icchalmers/Sit-To-Stand/BLEVibrator/Hardware/PCB/StrokeRehabilitation_KiCost.xlsx

 |  |  |  |  |  |  | Board Qty: | 100
 |  |  |  |  |  |  | Total Cost: | $0.00 |  |  |  | $0.00 |  |  |  |  |  | $0.00 |  |  |  |  |  | $0.00 |  |  |  |  |  | $0.00 |  |  |  |  |  | $0.00
 |  |  |  |  |  |  | Unit Cost: | $0.00
Global Part Info |  |  |  |  |  |  |  |  | Digi-Key |  |  |  |  |  | Mouser |  |  |  |  |  | Newark |  |  |  |  |  | Kitronik |  |  |  |  |  | Precisionmicrodrives
Refs | Value | Desc | Footprint | Manf | Manf# | Qty | Unit$ | Ext$ | Avail | Purch | Unit$ | Ext$ | Cat# | Doc | Avail | Purch | Unit$ | Ext$ | Cat# | Doc | Avail | Purch | Unit$ | Ext$ | Cat# | Doc | Avail | Purch | Unit$ | Ext$ | Cat# | Doc | Avail | Purch | Unit$ | Ext$ | Cat# | Doc
U1 | MCP73833 |  | IainPersonalLibrary:MCP73833-XXX_MF |  | MCP73833T-FCI/MF | 0 | $0.00 | $0.00 | 0 |  | $0.00 | $0.00 | MCP73833T-FCI/MF-ND | Link (http://www.digikey.com/scripts/DkSearch/dksus.dll?WT.z_header=search_go&lang=en) | 13336 |  | $0.00 | $0.00 | 579-MCP73833T-FCI/MF | Link (http://www.mouser.co.uk/Search/../ProductDetail/Microchip-Technology/MCP73833T-FCI-MF/) |  |  |  |  |  | Link (http://www.newark.com/webapp/wcs/stores/servlet/Search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)
U3 | RFD22301 |  | IainPersonalLibrary:RFD22301_RFDuino |  | RFD22301 | 0 | $0.00 | $0.00 | 3691 |  | $0.00 | $0.00 | 1562-1016-ND | Link (http://www.digikey.com/scripts/DkSearch/dksus.dll?WT.z_header=search_go&lang=en&keywords=RFD22301%20) | 2141 |  | $0.00 | $0.00 | 975-RFD22301 | Link (http://www.mouser.co.uk/Search/../ProductDetail/RF-Digital-Wireless/RFD22301/)
R3 | 5k |  | IainPersonalLibrary:Yageo_resistor_SMD_0805_reflow |  | RC0805FR-074K99L | 0 | $0.00 | $0.00 | 453863 |  | $0.00 | $0.00 | 311-4.99KCRCT-ND | Link (http://www.digikey.com/product-detail/en/yageo/RC0805FR-074K99L/311-4.99KCRCT-ND/730885) | 36675 |  | $0.00 | $0.00 | 603-RC0805FR-074K99L | Link (http://www.mouser.co.uk/Search/Refine.aspx?Keyword=RC0805FR-074K99L%20) |  |  |  |  |  | Link (http://www.newark.com/webapp/wcs/stores/servlet/Search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)
R1,R2,R6,R7 | 330 |  | IainPersonalLibrary:Yageo_resistor_SMD_0805_reflow |  | RC0805FR-07330RL | 0 | $0.00 | $0.00 | 549110 |  | $0.00 | $0.00 | 311-330CRCT-ND | Link (http://www.digikey.com/product-detail/en/yageo/RC0805FR-07330RL/311-330CRCT-ND/730813) | 73460 |  | $0.00 | $0.00 | 603-RC0805FR-07330RL | Link (http://www.mouser.co.uk/Search/Refine.aspx?Keyword=RC0805FR-07330RL%20) |  |  |  |  |  | Link (http://www.newark.com/yageo-phycomp/rc0805fr-07330rl/surface-mount-chip-resistor-thick/dp/48Y4545)
C5 | 100n |  | Capacitors_SMD:C_0603 |  | C1608X7R1E104K080AA | 0 | $0.00 | $0.00 | 1276107 |  | $0.00 | $0.00 | 445-1316-1-ND | Link (http://www.digikey.com/product-detail/en/tdk-corporation/C1608X7R1E104K080AA/445-1316-1-ND/567697) | 745369 |  | $0.00 | $0.00 | 810-C1608X7R1E104K | Link (http://www.mouser.co.uk/Search/Refine.aspx?Keyword=C1608X7R1E104K080AA%20) | 4250 |  | $0.00 | $0.00 | 90R7696 | Link (http://www.newark.com/tdk/c1608x7r1e104k080aa/ceramic-capacitor-0-1uf-25v-x7r/dp/90R7696)
C1,C2 | 1uF |  | IainPersonalLibrary:Murata_capacitor_SMD_0805_reflow |  | GRM21BR71C105KA01L | 0 | $0.00 | $0.00 | 209929 |  | $0.00 | $0.00 | 490-1691-1-ND | Link (http://www.digikey.com/product-detail/en/murata-electronics-north-america/GRM21BR71C105KA01L/490-1691-1-ND/587411) | 100112 |  | $0.00 | $0.00 | 81-GRM40X105K16L | Link (http://www.mouser.co.uk/Search/Refine.aspx?Keyword=GRM21BR71C105KA01L%20) | 6361 |  | $0.00 | $0.00 | 97K0638 | Link (http://www.newark.com/murata/grm21br71c105ka01l/capacitor-ceramic-1uf-16v-x7r/dp/97K0638)
D1,D3 | BI_LED_common_anode |  | IainPersonalLibrary:Bi_LED_SM1204BC-RG |  | SM1204BC-R/G | 0 | $0.00 | $0.00 | 0 |  | $0.00 | $0.00 | SM1204BC-R/G-ND | Link (http://www.digikey.com/scripts/DkSearch/dksus.dll?WT.z_header=search_go&lang=en) | 1853 |  | $0.00 | $0.00 | 749-SM1204BC-R/G | Link (http://www.mouser.co.uk/Search/Refine.aspx?Keyword=SM1204BC-R%2FG%20) |  |  |  |  |  | Link (http://www.newark.com/webapp/wcs/stores/servlet/Search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)
SW1 | SWITCH_INV |  | IainPersonalLibrary:SlideSwitch_SSSS810701 |  | SSSS810701 | 0 | $0.00 | $0.00 |  |  |  |  |  |  | 58585 |  | $0.00 | $0.00 | 688-SSSS810701 | Link (http://www.mouser.co.uk/Search/Refine.aspx?Keyword=SSSS810701%20)
Q2 | MOSFET_N |  | IainPersonalLibrary:MCPH3_SOT-323 |  | MCH3479-TL-H | 0 | $0.00 | $0.00 | 0 |  | $0.00 | $0.00 | MCH3479-TL-H-ND | Link (http://www.digikey.com/scripts/DkSearch/dksus.dll?WT.z_header=search_go&lang=en) |  |  |  |  |  | Link (http://www.mouser.co.uk/Search/Refine.aspx?Keyword=MCH3479-TL-H%20)
CON1 | USB-MICRO-B |  | IainPersonalLibrary:Micro_USB_Amphenol_10118192-0001LF |  | 10118192-0001LF | 0 | $0.00 | $0.00 | 222099 |  | $0.00 | $0.00 | 609-4613-1-ND | Link (http://www.digikey.com/product-detail/en/amphenol-fci/10118192-0001LF/609-4613-1-ND/2785378) | 36570 |  | $0.00 | $0.00 | 649-10118192-0001LF | Link (http://www.mouser.co.uk/Search/Refine.aspx?Keyword=10118192-0001LF%20) | 2447 |  | $0.00 | $0.00 | 67T2258 | Link (http://www.newark.com/webapp/wcs/stores/servlet/Search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)
C3 | 10uF |  | IainPersonalLibrary:Murata_capacitor_SMD_0805_reflow |  | GRM21BR61C106KE15L | 0 | $0.00 | $0.00 | 693435 |  | $0.00 | $0.00 | 490-3886-1-ND | Link (http://www.digikey.com/product-detail/en/murata-electronics-north-america/GRM21BR61C106KE15L/490-3886-1-ND/965928) | 254793 |  | $0.00 | $0.00 | 81-GRM21BR61C106KE15 | Link (http://www.mouser.co.uk/Search/Refine.aspx?Keyword=GRM21BR61C106KE15L%20) | 5307 |  | $0.00 | $0.00 | 35R0687 | Link (http://www.newark.com/murata/grm21br61c106ke15l/ceramic-capacitor-10uf-16v-x5r/dp/35R0687)
P2 | Programming Header |  | IainPersonalLibrary:RFDuino_programming_header |  |  | 0 | $0.00 | $0.00
P1 | CONN_01X01 |  | IainPersonalLibrary:TestPoint_SMD_1x1 |  |  | 0 | $0.00 | $0.00
R5,R8 | 50k |  | IainPersonalLibrary:Yageo_resistor_SMD_0805_reflow |  | RC0805FR-0749K9L | 0 | $0.00 | $0.00 | 153313 |  | $0.00 | $0.00 | 311-49.9KCRCT-ND | Link (http://www.digikey.com/product-detail/en/yageo/RC0805FR-0749K9L/311-49.9KCRCT-ND/730932) | 39576 |  | $0.00 | $0.00 | 603-RC0805FR-0749K9L | Link (http://www.mouser.co.uk/Search/Refine.aspx?Keyword=RC0805FR-0749K9L%20) |  |  |  |  |  | Link (http://www.newark.com/webapp/wcs/stores/servlet/Search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)
U2 | TPS73701_DRV_6 |  | IainPersonalLibrary:TPS73701_DRV_6 |  | TPS73733DRVR | 0 | $0.00 | $0.00 | 2923 |  | $0.00 | $0.00 | 296-40960-1-ND | Link (http://www.digikey.com/product-detail/en/texas-instruments/TPS73733DRVR/296-40960-1-ND/5178837) | 2280 |  | $0.00 | $0.00 | 595-TPS73733DRVR | Link (http://www.mouser.co.uk/Search/../ProductDetail/Texas-Instruments/TPS73733DRVR/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) |  |  |  |  |  | Link (http://www.newark.com/webapp/wcs/stores/servlet/Search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)
R4 | 10k |  | IainPersonalLibrary:Yageo_resistor_SMD_0805_reflow |  | RC0805FR-0710KL | 0 | $0.00 | $0.00 | 4019774 |  | $0.00 | $0.00 | 311-10.0KCRCT-ND | Link (http://www.digikey.com/product-detail/en/yageo/RC0805FR-0710KL/311-10.0KCRCT-ND/730482) | 721803 |  | $0.00 | $0.00 | 603-RC0805FR-0710KL | Link (http://www.mouser.co.uk/Search/Refine.aspx?Keyword=RC0805FR-0710KL%20) | 211447 |  | $0.00 | $0.00 | 68R0229 | Link (http://www.newark.com/webapp/wcs/stores/servlet/Search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)
R9 | 10M |  | Resistors_SMD:R_0603 |  | CRCW060310M0FKEA | 0 | $0.00 | $0.00 | 46211 |  | $0.00 | $0.00 | 541-10.0MHCT-ND | Link (http://www.digikey.com/product-detail/en/vishay-dale/CRCW060310M0FKEA/541-10.0MHCT-ND/1180266) | 64704 |  | $0.00 | $0.00 | 71-CRCW0603-10M-E3 | Link (http://www.mouser.co.uk/Search/../ProductDetail/Vishay-Dale/CRCW060310M0FKEA/) | 16618 |  | $0.00 | $0.00 | 52K8071 | Link (http://www.newark.com/vishay/crcw060310m0fkea/res-thick-film-10m-1-0-1w-0603/dp/52K8071)
C4 | 100p |  | IainPersonalLibrary:Murata_capacitor_SMD_0805_reflow |  | C0805C101J5GACTU | 0 | $0.00 | $0.00 | 311109 |  | $0.00 | $0.00 | 399-1122-1-ND | Link (http://www.digikey.com/product-detail/en/kemet/C0805C101J5GACTU/399-1122-1-ND/411397) | 251676 |  | $0.00 | $0.00 | 80-C0805C101J5G | Link (http://www.mouser.co.uk/Search/../ProductDetail/Kemet/C0805C101J5GACTU/) | 5774 |  | $0.00 | $0.00 | 70K9275 | Link (http://www.newark.com/kemet/c0805c101j5gactu/ceramic-capacitor-100pf-50v-c0g/dp/70K9275)
BT1 | 1S LiPo |  | IainPersonalLibrary:BatteryCon_WireSolder_0.8mm |  |  | 0 | $0.00 | $0.00 |  |  |  |  |  |  |  |  |  |  |  |  |  |  |  |  |  |  |  |  |  |  |  | Link (https://www.kitronik.co.uk/2209-polymer-lithium-ion-battery-37v-400mah.html)
Q1 | MOS_P |  | IainPersonalLibrary:Vishay_SOT-23 |  | SI2367DS-T1-GE3 | 0 | $0.00 | $0.00 | 8462 |  | $0.00 | $0.00 | SI2367DS-T1-GE3CT-ND | Link (http://www.digikey.com/product-detail/en/vishay-siliconix/SI2367DS-T1-GE3/SI2367DS-T1-GE3CT-ND/3758767) | 4784 |  | $0.00 | $0.00 | 781-SI2367DS-GE3 | Link (http://www.mouser.co.uk/Search/Refine.aspx?Keyword=SI2367DS-T1-GE3%20) | 627 |  | $0.00 | $0.00 | 35R6206 | Link (http://www.newark.com/vishay/si2367ds-t1-ge3/p-channel-mosfet-20v-3-8a/dp/35R6206)
D2,D4 | D_Schottky |  | IainPersonalLibrary:SOD-123F |  | PMEG2015EH | 0 | $0.00 | $0.00 | 4316 |  | $0.00 | $0.00 | 568-4116-1-ND | Link (http://www.digikey.com/product-detail/en/nxp-semiconductors/PMEG2015EH,115/568-4116-1-ND/1589931) |  |  |  |  |  | Link (http://www.mouser.co.uk/Search/Refine.aspx?Keyword=PMEG2015EH%20)
U4 | Brushed_DC_motor |  | IainPersonalLibrary:WireToBoard_1x2_TensionRelief |  | 307-103 | 0 | $0.00 | $0.00 |  |  |  |  |  |  |  |  |  |  |  | Link (http://www.mouser.co.uk/Search/../ProductDetail/Bussmann-Eaton/A307103/) |  |  |  |  |  |  |  |  |  |  |  |  |  |  |  |  |  | Link (https://www.precisionmicrodrives.com/product/307-103-9mm-vibration-motor-25mm-type)
R10 | 2.2M |  | Resistors_SMD:R_0603 |  | CRCW06032M20FKEA | 0 | $0.00 | $0.00 | 54954 |  | $0.00 | $0.00 | 541-2.20MHCT-ND | Link (http://www.digikey.com/product-detail/en/vishay-dale/CRCW06032M20FKEA/541-2.20MHCT-ND/1180188) | 11051 |  | $0.00 | $0.00 | 71-CRCW06032M20FKEA | Link (http://www.mouser.co.uk/Search/Refine.aspx?Keyword=CRCW06032M20FKEA%20) | 6504 |  | $0.00 | $0.00 | 89M6741 | Link (http://www.newark.com/webapp/wcs/stores/servlet/Search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)
 |  |  |  |  |  |  |  |  |  | 0 | 0 | 0 |  |  |  | 0 | 0 | 0 |  |  |  | 0 | 0 | 0 |  |  |  | 0 | 0 | 0 |  |  |  | 0 | 0 | 0
 |  |  |  |  |  |  |  |  |  | 0 | 0 | 0 |  |  |  | 0 | 0 | 0 |  |  |  | 0 | 0 | 0 |  |  |  | 0 | 0 | 0 |  |  |  | 0 | 0 | 0
 |  |  |  |  |  |  |  |  |  | 0 | 0 | 0 |  |  |  | 0 | 0 | 0 |  |  |  | 0 | 0 | 0 |  |  |  | 0 | 0 | 0 |  |  |  | 0 | 0 | 0
 |  |  |  |  |  |  |  |  |  | 0 | 0 | 0 |  |  |  | 0 | 0 | 0 |  |  |  | 0 | 0 | 0 |  |  |  | 0 | 0 | 0 |  |  |  | 0 | 0 | 0
 |  |  |  |  |  |  |  |  |  | 0 | 0 | 0 |  |  |  | 0 | 0 | 0 |  |  |  | 0 | 0 | 0 |  |  |  | 0 | 0 | 0 |  |  |  | 0 | 0 | 0
 |  |  |  |  |  |  |  |  |  | 0 | 0 | 0 |  |  |  | 0 | 0 | 0 |  |  |  | 0 | 0 | 0 |  |  |  | 0 | 0 | 0 |  |  |  | 0 | 0 | 0
 |  |  |  |  |  |  |  |  |  | 0 | 0 | 0 |  |  |  | 0 | 0 | 0 |  |  |  | 0 | 0 | 0 |  |  |  | 0 | 0 | 0 |  |  |  | 0 | 0 | 0
 |  |  |  |  |  |  |  |  |  | 0 | 0 | 0 |  |  |  | 0 | 0 | 0 |  |  |  | 0 | 0 | 0 |  |  |  | 0 | 0 | 0 |  |  |  | 0 | 0 | 0
 |  |  |  |  |  |  |  |  |  | 0 | 0 | 0 |  |  |  | 0 | 0 | 0 |  |  |  | 0 | 0 | 0 |  |  |  | 0 | 0 | 0 |  |  |  | 0 | 0 | 0
 |  |  |  |  |  |  |  |  |  | 0 | 0 | 0 |  |  |  | 0 | 0 | 0 |  |  |  | 0 | 0 | 0 |  |  |  | 0 | 0 | 0 |  |  |  | 0 | 0 | 0
 |  |  |  |  |  |  |  |  |  | 0 | 0 | 0 |  |  |  | 0 | 0 | 0 |  |  |  | 0 | 0 | 0 |  |  |  | 0 | 0 | 0 |  |  |  | 0 | 0 | 0
 |  |  |  |  |  |  |  |  |  | 0 | 0 | 0 |  |  |  | 0 | 0 | 0 |  |  |  | 0 | 0 | 0 |  |  |  | 0 | 0 | 0 |  |  |  | 0 | 0 | 0
 |  |  |  |  |  |  |  |  |  | 0 | 0 | 0 |  |  |  | 0 | 0 | 0 |  |  |  | 0 | 0 | 0 |  |  |  | 0 | 0 | 0 |  |  |  | 0 | 0 | 0
 |  |  |  |  |  |  |  |  |  | 0 | 0 | 0 |  |  |  | 0 | 0 | 0 |  |  |  | 0 | 0 | 0 |  |  |  | 0 | 0 | 0 |  |  |  | 0 | 0 | 0
 |  |  |  |  |  |  |  |  |  | 0 | 0 | 0 |  |  |  | 0 | 0 | 0 |  |  |  | 0 | 0 | 0 |  |  |  | 0 | 0 | 0 |  |  |  | 0 | 0 | 0
 |  |  |  |  |  |  |  |  |  | 0 | 0 | 0 |  |  |  | 0 | 0 | 0 |  |  |  | 0 | 0 | 0 |  |  |  | 0 | 0 | 0 |  |  |  | 0 | 0 | 0
 |  |  |  |  |  |  |  |  |  | 0 | 0 | 0 |  |  |  | 0 | 0 | 0 |  |  |  | 0 | 0 | 0 |  |  |  | 0 | 0 | 0 |  |  |  | 0 | 0 | 0
 |  |  |  |  |  |  |  |  |  | 0 | 0 | 0 |  |  |  | 0 | 0 | 0 |  |  |  | 0 | 0 | 0 |  |  |  | 0 | 0 | 0 |  |  |  | 0 | 0 | 0
 |  |  |  |  |  |  |  |  |  | 0 | 0 | 0 |  |  |  | 0 | 0 | 0 |  |  |  | 0 | 0 | 0 |  |  |  | 0 | 0 | 0 |  |  |  | 0 | 0 | 0
 |  |  |  |  |  |  |  |  |  | 0 | 0 | 0 |  |  |  | 0 | 0 | 0 |  |  |  | 0 | 0 | 0 |  |  |  | 0 | 0 | 0 |  |  |  | 0 | 0 | 0
 |  |  |  |  |  |  |  |  |  | 0 | 0 | 0 |  |  |  | 0 | 0 | 0 |  |  |  | 0 | 0 | 0 |  |  |  | 0 | 0 | 0 |  |  |  | 0 | 0 | 0
 |  |  |  |  |  |  |  |  |  | 0 | 0 | 0 |  |  |  | 0 | 0 | 0 |  |  |  | 0 | 0 | 0 |  |  |  | 0 | 0 | 0 |  |  |  | 0 | 0 | 0
 |  |  |  |  |  |  |  |  |  | 0 | 0 | 0 |  |  |  | 0 | 0 | 0 |  |  |  | 0 | 0 | 0 |  |  |  | 0 | 0 | 0 |  |  |  | 0 | 0 | 0
