icchalmers/Sit-To-Stand/BLEVibrator/Hardware/Case/CaseBottom.stl

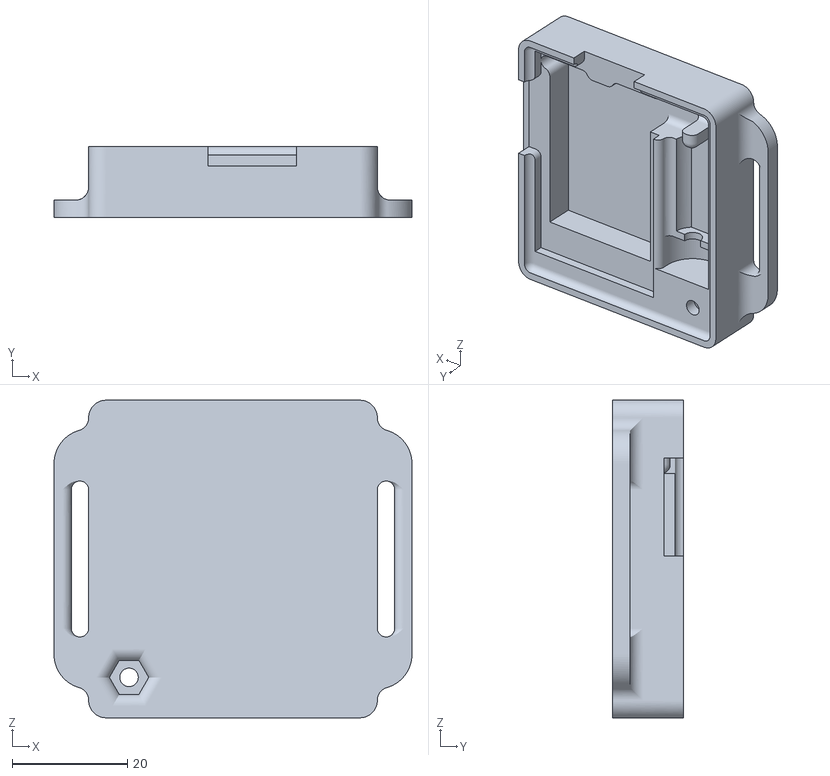
[picture p1: CAD file, 2016-08-01]
BLEVibrator/Hardware/Case/CaseBottom.stl
62.0 x 12.3 x 55.0
