icchalmers/Sit-To-Stand/BLEVibrator/Hardware/Case/CaseTop.stl

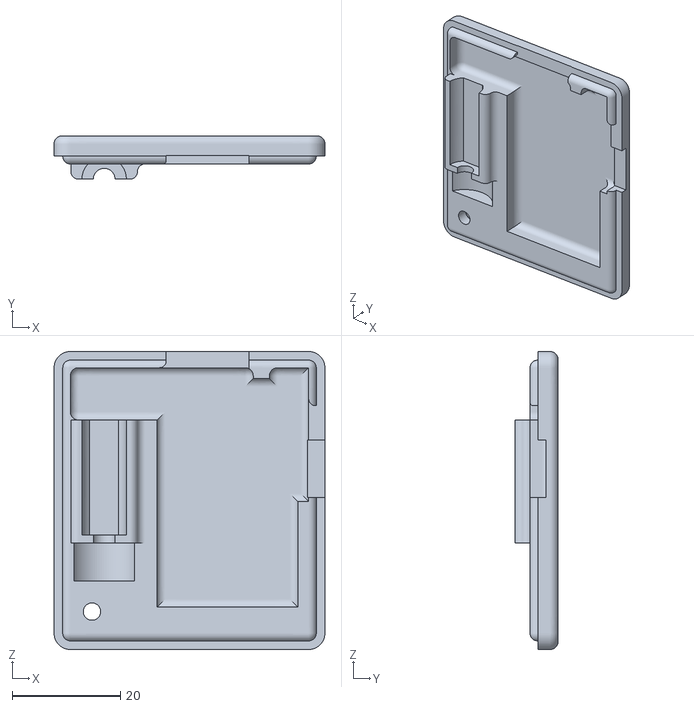
[picture p2: CAD file, 2016-08-01]
BLEVibrator/Hardware/Case/CaseTop.stl
50.0 x 8.00 x 55.0
