icchalmers/Sit-To-Stand/(list of files, cad)

Other CAD files:
BLEVibrator/Hardware/Case/10118192C_USBHeader.ipt
BLEVibrator/Hardware/Case/308-106.ipt
BLEVibrator/Hardware/Case/BarePCB.ipt
BLEVibrator/Hardware/Case/CaseAssembly.iam
BLEVibrator/Hardware/Case/CaseBase.ipt
BLEVibrator/Hardware/Case/CaseBottom.ipt
BLEVibrator/Hardware/Case/CaseTop.ipt
BLEVibrator/Hardware/Case/FullUnitAssembly.iam
BLEVibrator/Hardware/Case/PCBAssembly.iam
BLEVibrator/Hardware/Case/RFDuino.ipt
BLEVibrator/Hardware/Case/SM1204XXX_LED.ipt
BLEVibrator/Hardware/Case/SSSS810701_SlideSwitch.ipt
