icchalmers/Sit-To-Stand/BLEVibrator/Hardware/PCB/StrokeRehabilitation_Schematic.pdf

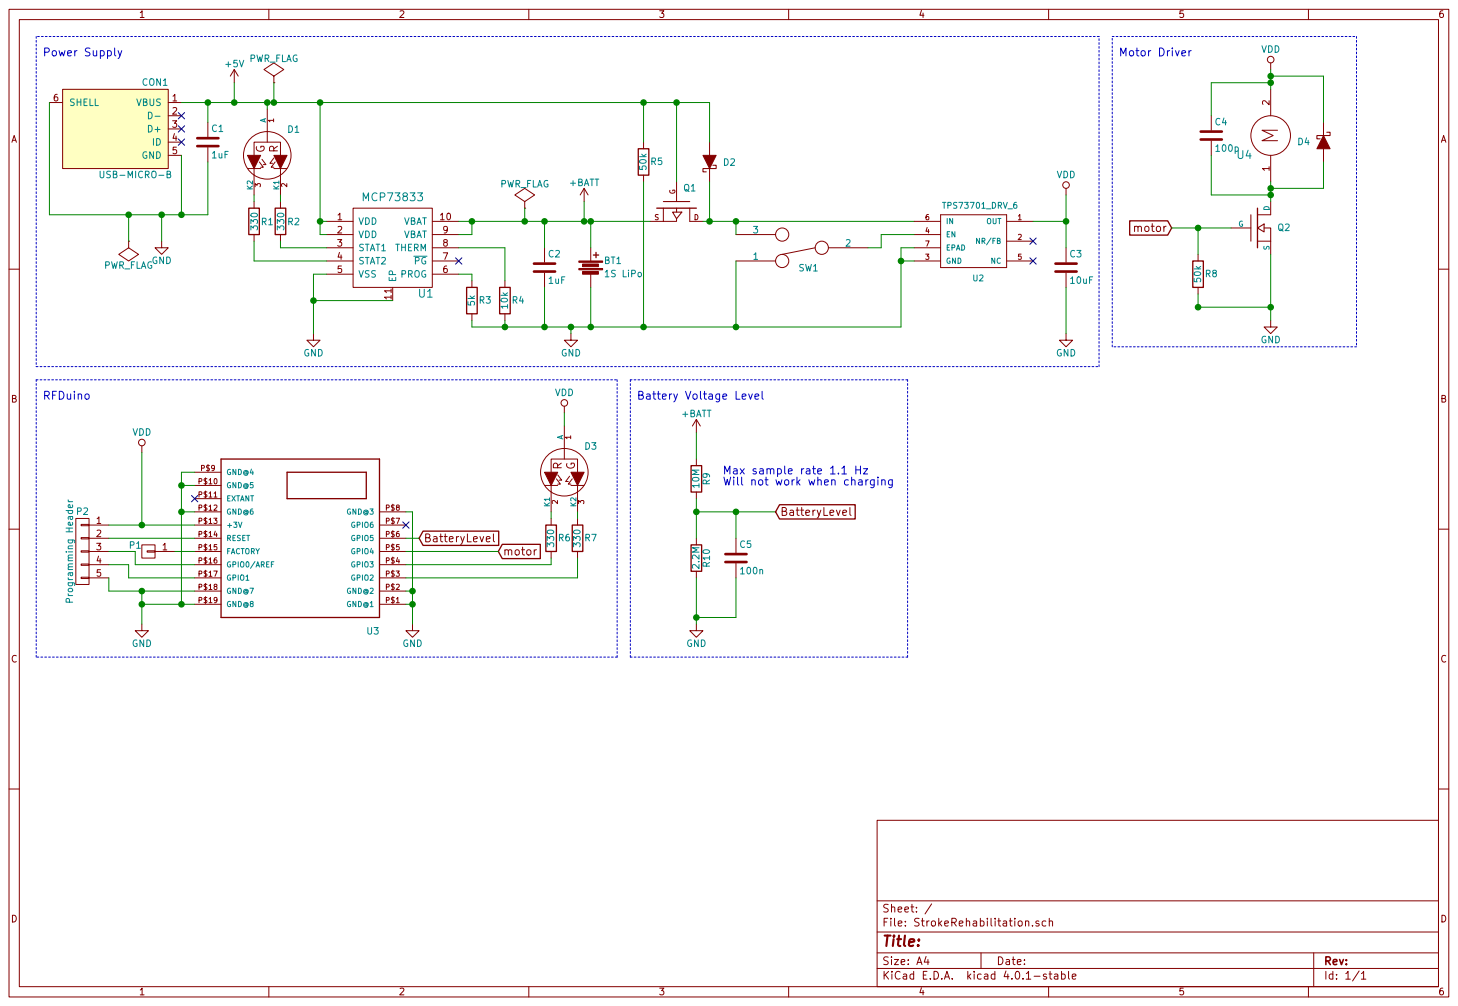
[picture p3: page 1]

Max sample rate 1.1 Hz
Will not work when charging

Id: 1/1 Title: File: StrokeRehabilitation.sch Sheet: /
