icchalmers/Sit-To-Stand/BLEVibrator/Hardware/PCB/StrokeRehabilitation.kicad_pcb

## KiCad design BLEVibrator/Hardware/PCB/StrokeRehabilitation.kicad_pcb (2016-08-01)

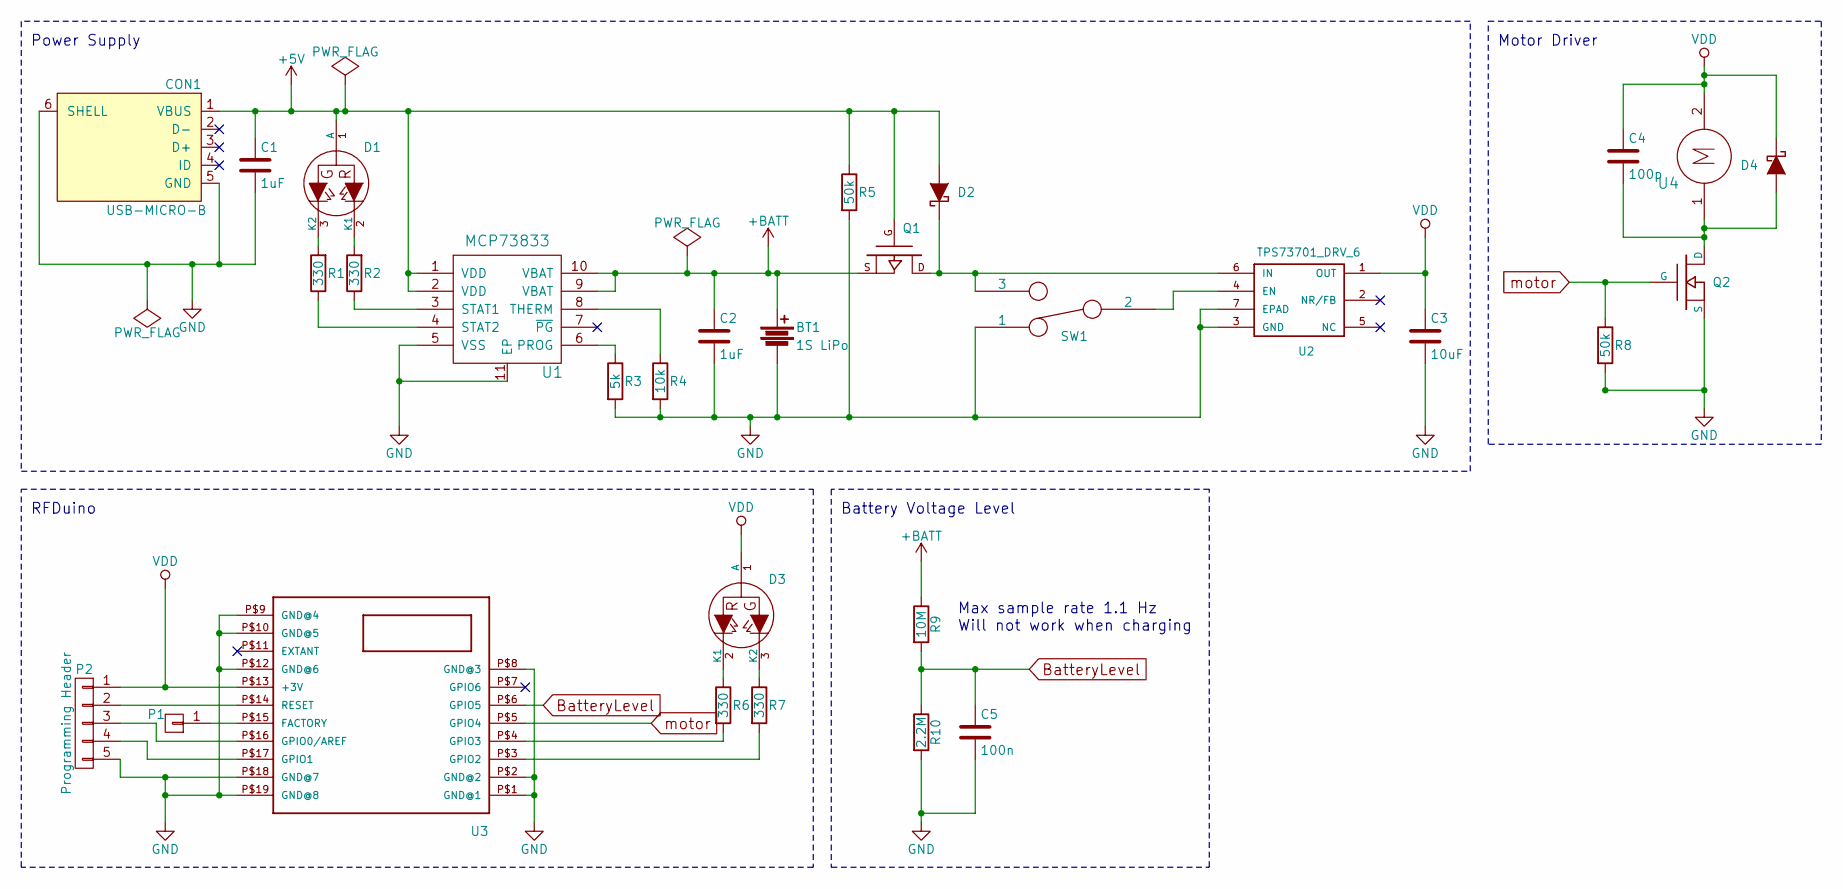
[picture p4: schematic StrokeRehabilitation.sch]

Parts:
BT1: 1S LiPo; BatteryCon_WireSolder_0.8mm
C1, C2: 1uF; Murata_capacitor_SMD_0805_reflow
C3: 10uF; Murata_capacitor_SMD_0805_reflow
C4: 100p; Murata_capacitor_SMD_0805_reflow
C5: 100n; C_0603
CON1: USB-MICRO-B; Micro_USB_Amphenol_10118192-0001LF
D1, D3: BI_LED_common_anode; Bi_LED_SM1204BC-RG
D2, D4: D_Schottky; SOD-123F
P1: CONN_01X01; TestPoint_SMD_1x1
P2: Programming Header; RFDuino_programming_header
Q1: MOS_P; Vishay_SOT-23
Q2: MOSFET_N; MCPH3_SOT-323
R1, R2, R6, R7: 330; Yageo_resistor_SMD_0805_reflow
R3: 5k; Yageo_resistor_SMD_0805_reflow
R4: 10k; Yageo_resistor_SMD_0805_reflow
R5, R8: 50k; Yageo_resistor_SMD_0805_reflow
R9: 10M; R_0603
R10: 2.2M; R_0603
SW1: SWITCH_INV; SlideSwitch_SSSS810701
U1: MCP73833; MCP73833-XXX_MF
U2: TPS73701_DRV_6
U3: RFD22301; RFD22301_RFDuino
U4: Brushed_DC_motor; WireToBoard_1x2_TensionRelief

Connections:
+5V: C1.1, CON1.1 (VBUS), D1.1 (A), D2.2 (A), Q1.G, R5.1, U1.1 (VDD), U1.2 (VDD)
+BATT: BT1.1, C2.1, Q1.S, R9.1, U1.9 (VBAT), U1.10 (VBAT)
BatteryLevel: C5.1, R9.2, R10.1, U3.P$6 (GPIO5)
GND: BT1.2, C1.2, C2.2, C3.2, C5.2, CON1.5 (GND), CON1.6 (SHELL), P2.5, Q2.S, R3.2, R4.2, R5.2, R8.2, R10.2, SW1.1, U1.5 (VSS), U1.11 (EP), U2.3 (GND), U2.7 (EPAD), U3.P$1 (GND@1), U3.P$2 (GND@2), U3.P$8 (GND@3), U3.P$9 (GND@4), U3.P$10 (GND@5), U3.P$12 (GND@6), U3.P$18 (GND@7), U3.P$19 (GND@8)
unnamed: C4.2, D4.2 (A), Q2.D, U4.1
unnamed: D1.2 (K1), R2.2
unnamed: D1.3 (K2), R1.2
unnamed: D2.1 (K), Q1.D, SW1.3, U2.6 (IN)
unnamed: D3.2 (K1), R6.1
unnamed: D3.3 (K2), R7.1
unnamed: P1.1, U3.P$15 (FACTORY)
unnamed: P2.2, U3.P$14 (RESET)
unnamed: P2.3, U3.P$16 (GPIO0/AREF)
unnamed: P2.4, U3.P$17 (GPIO1)
unnamed: R1.1, U1.4 (STAT2)
unnamed: R2.1, U1.3 (STAT1)
unnamed: R3.1, U1.6 (PROG)
unnamed: R4.1, U1.8 (THERM)
unnamed: R6.2, U3.P$4 (GPIO3)
unnamed: R7.2, U3.P$3 (GPIO2)
unnamed: SW1.2, U2.4 (EN)
VDD: C3.1, C4.1, D3.1 (A), D4.1 (K), P2.1, U2.1 (OUT), U3.P$13 (+3V), U4.2
motor: Q2.G, R8.1, U3.P$5 (GPIO4)

Notes on the sheet:
Power Supply
RFDuino
Motor Driver
Max sample rate 1.1 Hz Will not work when charging
Battery Voltage Level

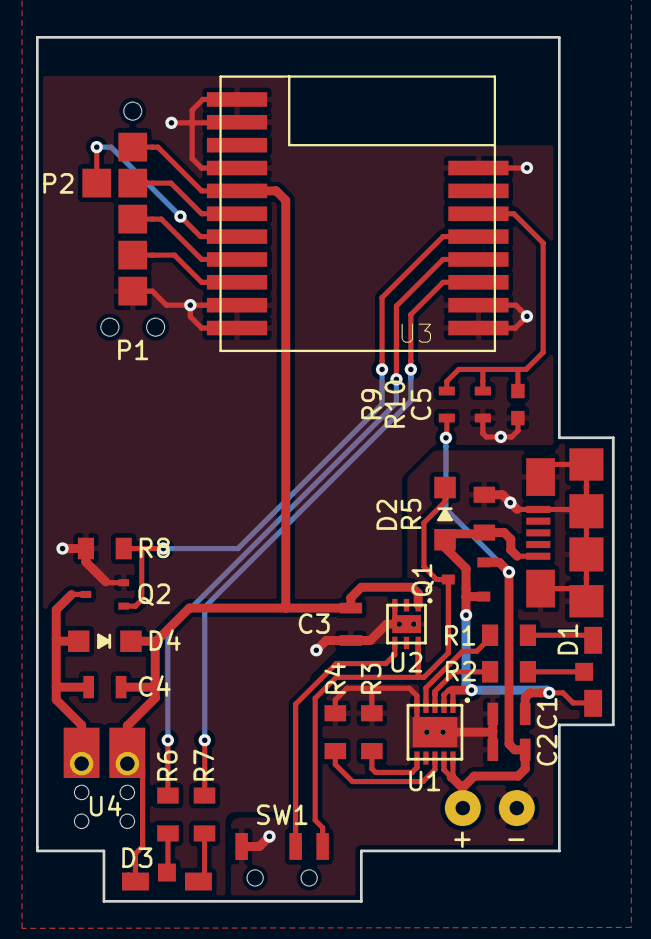
[picture p5: board StrokeRehabilitation.kicad_pcb from above]

Board: 2 copper layers, 32.0 x 48.0 mm, 30 parts (0 on the bottom side), 23 nets.
