icchalmers/Sit-To-Stand/(commit log)

2015-01-30 Initial Application uploaded to BitBucket, currently reads Gyroscope values and displays them on the screen
2015-02-06 Added URL of devweb site to Android application to load correct application on start up.
    [Screen.java]
2015-02-11 Moved code from current project onto devweb, and setup new project for editing this
2015-02-13 Added bootstrap framework to improve UI
2015-02-17 Commit of yesterdays work, which resolved the averaging angles issue, by treating them as bearings and taking the arctan of the sum of sins over sum of cos for each coordinate
2015-02-18 Added setup script to get screen dimensions and create button to start program
2015-02-19 Added AngularJS locally to enable faster loading times Set-up start button to disappear when clicked and calibration page to appear Started calibration page Added Progress bar to calibration page
2015-02-19 Made start button truly full-screen using dynamic style by angularJS
2015-03-03 Updated switching screens to give strings rather than ints to make understanding current screen easier Removed AngularJS docs to make app smaller Fixed OrientationEvent to only take one reading at a 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
2015-03-03 Revert "Updated switching screens to give strings rather than ints to make understanding current screen easier"
    This reverts commit 92f61d7b612b5014e6f735e95e22ce581b668102.
2015-03-04 Implemented calibration fully Implemented next screen to show raw data, calibrated values and differentials Added button for done to restart program
2015-03-04 Removed documentation for AngularJS Added smoothing to alpha to help with jumpy results Added reset button to restart application when completed
2015-03-09 Increased font sizes to make reading easier when recording user tests Added smoothing algorithm to beta and gamma Normalised alpha to run from 0 to 360 Changed calibration time to 15s
2015-03-13 Added check for Android to stop crash on other OS
    [Screen.java]
2015-03-17 Made buttons larger on first screen Doubled values of gamma so it now displays in 360 degree
2015-03-19 Added Arduino code to repository Simple code to test communication between Arduinos to find working Xbee modules
2015-03-19 Code now recieves serial by bluetooth and sends it on to the other Arduino
2015-03-19 Configured webApp to send messages to Arduino Setup High/Low buttons to toggle light on Arduino for testing Removed unused classes in Android
2015-03-23 Updated Arduino code to enable/disable vibration when high and low is pressed on the JS app
2015-03-23 Made some nice CSS for full-screen and centre-vertical to replace horrible JS method for full screen button, should be more universal
2015-03-24 JS now tells motors to vibrate when angle is more than 30 degree from calibrated. Currently both motors vibrate at the same time
2015-03-24 Changed averaging rate to 10Hz
2015-03-24 Updated codes to set one motor on when left and the other when right
2015-03-24 Set up code to send protocol from JS to Arduino to control strength and direction of vibration Some issues with Arduino that the input is not clearing correctly
2015-03-24 Fixed error that stopped arduino from clearing message. Message was constantly being expanded in JS, added clear method that should solve issue.
2015-03-26 Fixed issue where sending HIGH to Arduino after using it once would not set correct speed
2015-04-09 Minor tweaks to improve stability
    [Screen.java]
2016-03-03 Replace original Arduino code with RFDuino code to match the new vibration hardware
    [BLEVibrator.ino]
2016-03-03 Fixing top level naming structure
    [BLEVibrator.ino]
2016-03-23 Adding blank activities for scanning and controling motors
    [activity_motor_control.xml, activity_motor_scan.xml, content_motor_control.xml, content_motor_scan.xml]
2016-03-23 Didn't actually need these...
    [activity_motor_control.xml, activity_motor_scan.xml, content_motor_control.xml, content_motor_scan.xml]
2016-03-23 Adding new layout commponents
    [activity_motor_control.xml]
2016-03-23 First attempt at getting BLE integrated. Still lots of bugs...
    [MotorControlActivity.java, MotorScanActivity.java, Screen.java]
2016-03-25 Request lcoation permission to get around bug in Android M where scan results are otherwise missing. General clean up of BLE management code. Can now reliably write to two BLE devices at the same tim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
    [MotorControlActivity.java, MotorScanActivity.java]
2016-03-28 Getting ready to integrate BLE comms with original HTML5 code
    [activity_motor_control.xml]
2016-03-28 Making motor controls disabled until the connections have been made
    [activity_motor_control.xml]
2016-03-28 Adding funtionality to Calibrate button. The HTML based part of the app can now connect and send to the motors
2016-03-28 Working! Shifts on the angle of the phone now get sent as feedback to the motors. Currently only works when phone is in the original landscape orientation
2016-03-28 Fix bug in angle calibration
2016-03-28 Added some crude low pass filtering on orientation angle data to help remove noise. Alpha is still quite susceptible to large variations due to it using the magnetic compass which is pretty unstable
2016-03-28 Adding TODO for coordinate translation from Earth to Device
2016-03-29 Stopped BLEMotorService leaking from screen activity on back buttoning
    [Screen.java]
2016-03-29 Fixing action bar to display buttons
2016-03-29 Changing title of MotorControlActivity
2016-04-04 Adding functionality to get the device yaw using the Android SensorManager. Using the JS deviceMotion and deviceOrientation events in JS was very device dependent. This way, it should be a bit more m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
2016-04-04 Updating to use Android SensorManager based calculated 'yaw' rather than azimuth (the degrees to north. This is done using a quick-fix of just grabbing the SensorManager based yaw when deviceOrientat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
2016-04-05 Adding some crude disconnect functionality to the motor setup activity (MotorControlActivity). There are some bad interactions when a user start calibration and then uses the back button.
2016-04-05 Updated MotorControlACtivity to have more useful features. Removed the 'Disable Motors' button and the slider. Instead, replaced with buttons that trigger a 1s pulse on the left/right motors and also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
    [activity_motor_control.xml]
2016-04-05 Disable the ability to switch motors while they are being identified. The method is a bit sloppy - it would be better to disable the motors and then switch. The 1s delayed task makes this a bit awkwa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
    [MotorControlActivity.java]
2016-04-05 Adding the 3d printed case design files
    [CaseBottom.ipt, CaseTop.ipt, CaseTop.stl]
2016-04-05 Initial commit of PCB files
    [StrokeRehabilitation.kicad_pcb, StrokeRehabilitation.sch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]
2016-04-05 Merging BLE branch.
    The project now has completely redesigned vibration motors designed around Bluetooth Low Energy connections. The app has been updated accordingly.
    [CaseBottom.ipt, CaseTop.ipt, CaseTop.stl, StrokeRehabilitation.kicad_pcb, StrokeRehabilitation.sch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]
2016-04-05 Adding an APK of the app as it currently stands so people can get going without having to build the project
2016-04-05 Fixing license header on files that came from example code that had an exising licence
    [BLEMotorService.java, MotorControlActivity.java, MotorScanActivity.java]
2016-04-05 Abstracting out some common code for motor identification
2016-04-25 Adding PCB parts discussion
2016-05-22 Making the deadzone/bandwidth a user controllable parameter
    [activity_motor_control.xml]
2016-06-06 Updated the PCB to have a side-mounted slide switch and connection status LED. The case still needs to be updated to match
    [StrokeRehabilitation.kicad_pcb, StrokeRehabilitation.sch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]
2016-06-06 adding .gitignore for KiCad backup files
2016-06-06 Updating case to have a slot for the new side mounted switch and LED. Also made battery slot 1mm longer to match the batch of 440mAh batteries I get sent that are slightly longer than the 400mAh. Als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
    [CaseBottom.ipt, CaseTop.ipt, CaseTop.stl]
2016-06-09 Increased the width of the slot on the front of the case for the switch/LED to make it a slightly less snugg fit
    [CaseBottom.ipt, CaseTop.ipt, CaseTop.stl]
2016-06-09 Updated schematic and netlist to include lipo charging with a micro USB header
    [StrokeRehabilitation.sch]
2016-06-13 reduced size of extension for 440mAh battery slot from 1mm to 0.5mm based on printed prototype
    [CaseBottom.ipt, CaseBottom.stl]
2016-06-13 Moved side mount LED back a little bit to make placement and soldering easier
    [StrokeRehabilitation.kicad_pcb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]
2016-06-20 Adding KiCAD autosave files to .gitignore
2016-06-20 Cleaned up schematic. Fixed symbols to have pins for matching footprints e.g. exposed thermal pads. Changed LED resistors from 500 to 330 (closer to 4 mA per pin limit of RFDuino, and still within 20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
    [StrokeRehabilitation.sch]
2016-06-22 Routed the new PCB. Assigned correct footprints in schematic
    [StrokeRehabilitation.kicad_pcb, StrokeRehabilitation.sch]
2016-06-22 Turning back on missing back layers now that it is a two sided board
    [StrokeRehabilitation.kicad_pcb]
2016-06-24 Added circuitry to enable monitoring of the LiPo voltage. Based on https://devzone.nordicsemi.com/question/990/how-to-measure-lithium-battery-voltage/ and https://devzone.nordicsemi.com/blogs/30/meas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
    [StrokeRehabilitation.sch]
2016-06-24 Place and route of LiPo voltage monitoring circuit
    [StrokeRehabilitation.kicad_pcb]
2016-06-24 Adding a test point for FACTORY pin of the RFDuino, in case SWD programming is needed in the future
    [StrokeRehabilitation.kicad_pcb, StrokeRehabilitation.sch]
2016-06-24 Added back silkscreen with board info
    [StrokeRehabilitation.kicad_pcb]
2016-06-24 New gerbers generated for v0.3 i.e. the first iteration of the board to be double sided and professionally fabricated
    [StrokeRehabilitation-B.Cu.gbl, StrokeRehabilitation-B.Mask.gbs, StrokeRehabilitation-B.SilkS.gbo, StrokeRehabilitation-Edge.Cuts.gm1, StrokeRehabilitation-F.Cu.gtl, StrokeRehabilitation-F.Mask.gts, StrokeRehabilitation-F.Paste.gtp, StrokeRehabilitation-F.SilkS.gto]
2016-06-24 Adding pdf of the schematic and svg of the PCB layout for easy reference without having KiCAD
    [StrokeRehabilitation.sch]
2016-06-24 Added manufacturer part numbers to parts in schematic. Generated a BOM in KiCAD and a rough costing (US-based) using KiCost
    [StrokeRehabilitation.sch, StrokeRehabilitation_KiCost.xlsx]
2016-06-24 Fixing link formatting - I'm really bad for mixing my brakets apparently...
2016-06-24 Cleaned up silkscreen label placement
    [StrokeRehabilitation-B.Cu.gbl, StrokeRehabilitation-B.Mask.gbs, StrokeRehabilitation-B.SilkS.gbo, StrokeRehabilitation-Edge.Cuts.gm1, StrokeRehabilitation-F.Cu.gtl, StrokeRehabilitation-F.Mask.gts, StrokeRehabilitation-F.Paste.gtp, StrokeRehabilitation-F.SilkS.gto]
2016-06-24 more clean up of silkscreen label placement
    [StrokeRehabilitation-B.Cu.gbl, StrokeRehabilitation-B.Mask.gbs, StrokeRehabilitation-B.SilkS.gbo, StrokeRehabilitation-Edge.Cuts.gm1, StrokeRehabilitation-F.Cu.gtl, StrokeRehabilitation-F.Mask.gts, StrokeRehabilitation-F.Paste.gtp, StrokeRehabilitation-F.SilkS.gto]
2016-08-01 Marking Inventor assembly .iam, Inventor part .ipt, .STL and .thing files as binary
2016-08-01 New case to fit the new motor and the new PCB
    [10118192C_USBHeader.ipt, 308-106.ipt, BarePCB.ipt, CaseAssembly.iam, CaseBase.ipt, CaseBottom.ipt, CaseBottom.stl, CaseTop.ipt]
2016-08-01 Update README with info on velcro strap
2016-08-01 Update readme for PCB
2016-08-01 Updating sketch to use 32 as minimum turn on value to match the new 308-106 motor
